lendres/Li-Ion-Boost-Charge-Protect-Boards/Li-ion 5.5A Boost 1A Charge Protect/Li-ion 5.5A Boost 1A Charge Protect.kicad_pcb

## KiCad design Li-ion 5.5A Boost 1A Charge Protect/Li-ion 5.5A Boost 1A Charge Protect.kicad_pcb (2021-11-19)

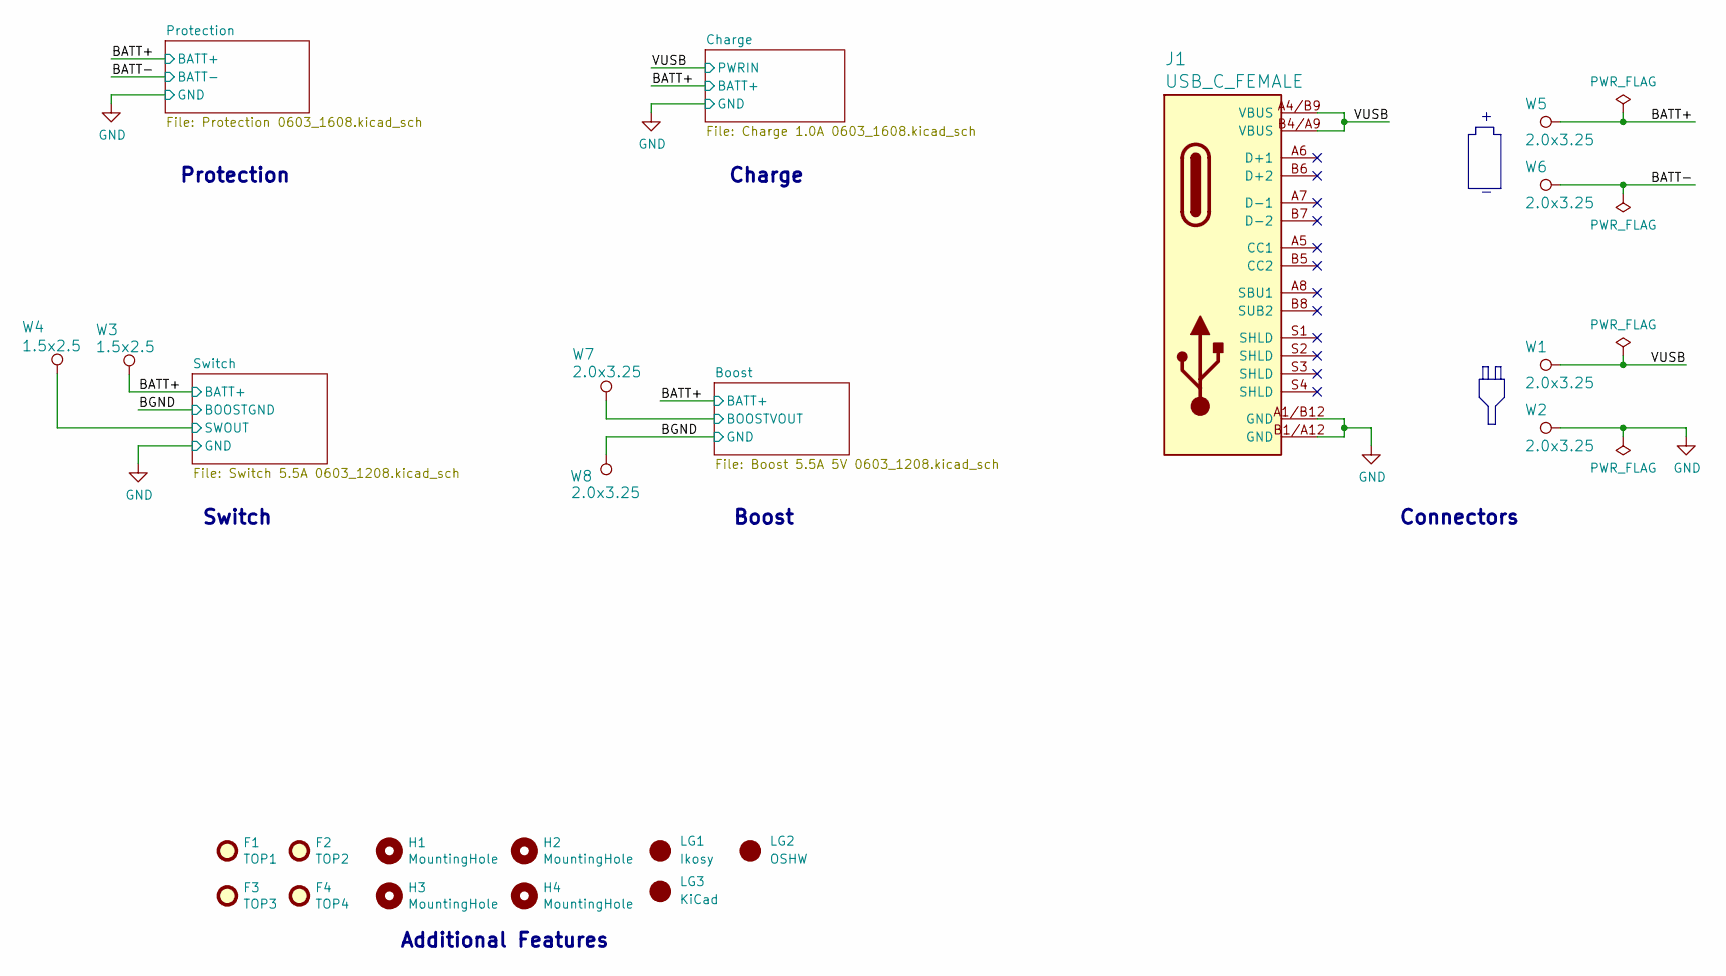
[picture p1: schematic Li-ion 5.5A Boost 1A Charge Protect.kicad_sch, Li-ion 5A Boost 1A Charge Protect]

Parts:
F1, F2, F3, F4: Fiducial; Fiducial_1mm_Mask2mm; Manufacturer Part No. None
H1, H2, H3, H4: MountingHole; MountingHole_2.2mm_M2; Manufacturer Part No. None
J1: USB_C_FEMALE; GCT_USB4110-GF-A; Manufacturer Part No. USB4110-GF-A
LG1: Logo; Ikosy-Logo_Type1_10.3x2mm_SilkScreen; Manufacturer Part No. None
LG2: Logo; OSHW-Symbol_3mm_Silkscreen; Manufacturer Part No. None
LG3: Logo; KiCad-Logo3_3mm_SilkScreen; Manufacturer Part No. None
W1, W2, W5, W6, W7, W8: 2.0x3.25; Pad_2.0-3.25_w_TH; Manufacturer Part No. None
W3, W4: 1.5x2.5; Pad_1.5-2.5_w_TH; Manufacturer Part No. None

Connections:
/BATT+: W3.1, W5.1; also elsewhere on the board
/BATT-: W6.1; also elsewhere on the board
/BGND: W8.1; also elsewhere on the board
/Boost/BOOSTVOUT: W7.1; also elsewhere on the board
/Switch/SWOUT: W4.1; also elsewhere on the board
/VUSB: J1.A4/B9 (VBUS), J1.B4/A9 (VBUS), W1.1; also elsewhere on the board
GND: J1.A1/B12 (GND), J1.B1/A12 (GND), W2.1; also elsewhere on the board

Notes on the sheet:
Protection
Switch
Connectors
Additional Features
Charge
Boost

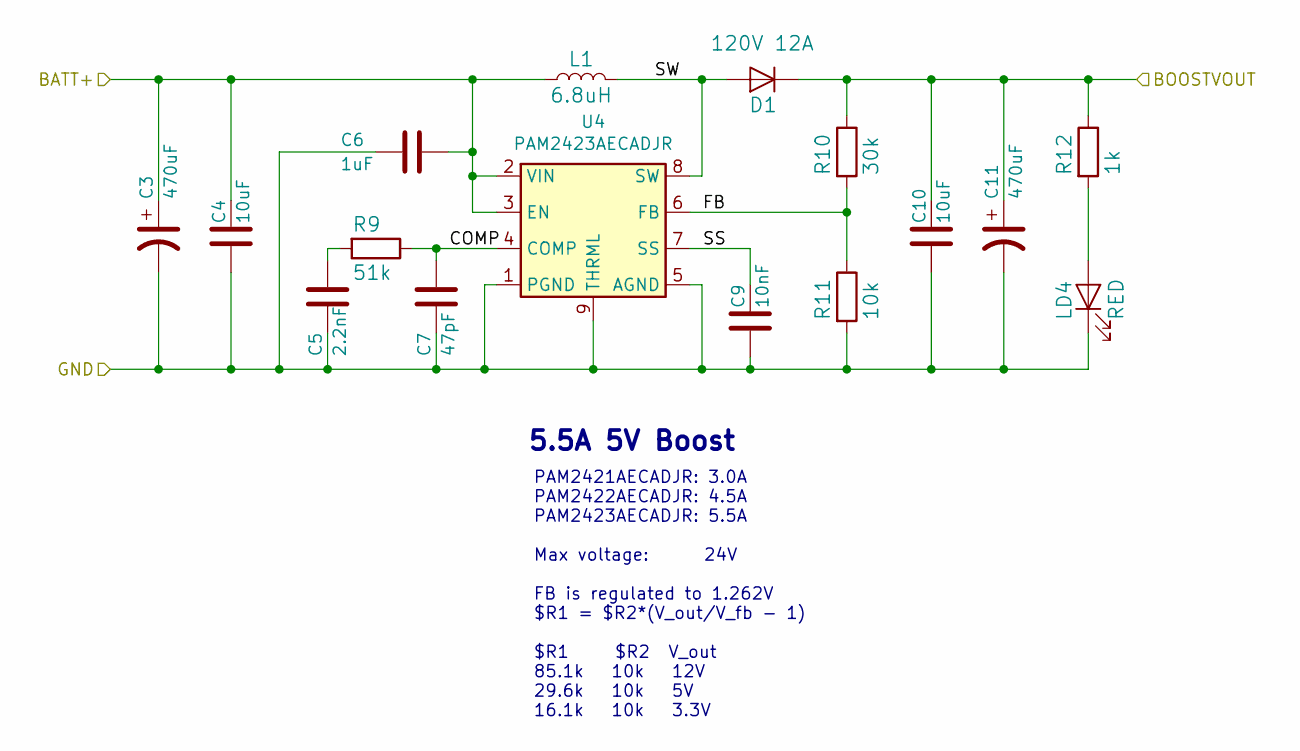
[picture p2: schematic Boost 5.5A 5V 0603_1208.kicad_sch, 5.5A 5V Boost]

Parts:
C3, C11: 470uF; CP_Elec_10x10.5; Manufacturer Part No. 25TLV470M10X10.5
C4, C10: 10uF; 0603_1608Metric; Manufacturer Part No. CL10A106KP8NQSC
C5: 2.2nF; 0603_1608Metric; Manufacturer Part No. CL10B222KB8NFNC
C6: 1uF; 0603_1608Metric; Manufacturer Part No. CL10A105KA8NFNC
C7: 47pF; 0603_1608Metric; Manufacturer Part No. CL10C470JB81PNC
C9: 10nF; 0603_1608Metric; Manufacturer Part No. CL10B103KB8NNNL
D1: 120V 12A; NTS12120EMFST1G; Manufacturer Part No. NTS12120EMFST1G
L1: 6.8uH; L_MGV1004; Manufacturer Part No. MGV10046R8M-10
LD4: RED; LED_0805_2012Metric; Manufacturer Part No. 150080RS75000
R9: 51k; 0603_1608Metric; Manufacturer Part No. ESR03EZPF5102
R10: 30k; 0603_1608Metric; Manufacturer Part No. ESR03EZPF3002
R11: 10k; 0603_1608Metric; Manufacturer Part No. ESR03EZPF1002
R12: 1k; 0603_1608Metric; Manufacturer Part No. ESR03EZPF1001
U4: PAM2423AECADJR; Manufacturer Part No. PAM2423AECADJR

Connections:
/BATT+: C3.1, C4.1, C6.1, L1.1, U4.2 (VIN), U4.3 (EN); also elsewhere on the board
/BGND: C3.2, C4.2, C5.2, C6.2, C7.2, C9.2, C10.2, C11.2, LD4.1 (K(N)), R11.2, U4.1 (PGND), U4.5 (AGND), U4.9 (THRML); also elsewhere on the board
/Boost/BOOSTVOUT: C10.1, C11.1, D1.5 (K), D1.5A (K), D1.5B (K), D1.5C (K), D1.5D (K), R10.1, R12.1; also elsewhere on the board
/Boost/COMP: C7.1, R9.1, U4.4 (COMP)
/Boost/FB: R10.2, R11.1, U4.6 (FB)
/Boost/SS: C9.1, U4.7 (SS)
/Boost/SW: D1.1 (A), D1.2 (A), D1.3 (A), L1.2, U4.8 (SW)
unnamed: C5.1, R9.2
unnamed: LD4.2 (A(P)), R12.2

Notes on the sheet:
5.5A 5V Boost
PAM2421AECADJR: 3.0A PAM2422AECADJR: 4.5A PAM2423AECADJR: 5.5A Max voltage: 24V FB is regulated to 1.262V $R1 = $R2*(V_out/V_fb - 1) $R1 $R2 V_out 85.1k 10k 12V 29.6k 10k 5V 16.1k 10k 3.3V

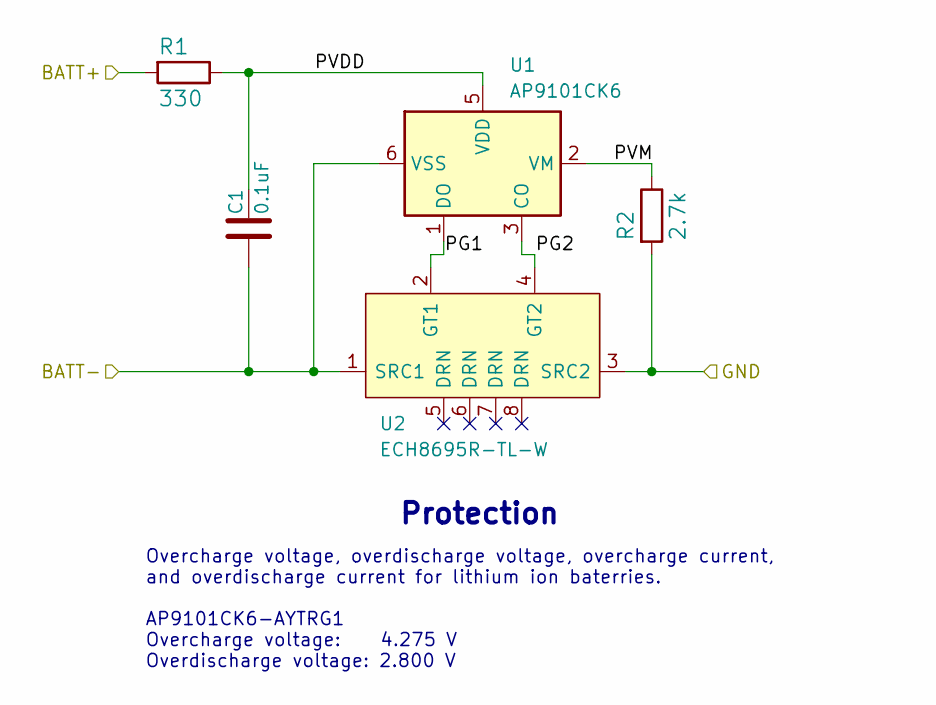
[picture p3: schematic Protection 0603_1608.kicad_sch]

Parts:
C1: 0.1uF; 0603_1608Metric; Manufacturer Part No. CL10B104JB8NNNC
R1: 330; 0603_1608Metric; Manufacturer Part No. BUK6D30-40EX
R2: 2.7k; 0603_1608Metric; Manufacturer Part No. ESR03EZPF2701
U1: AP9101CK6; SOT-23-6; Manufacturer Part No. AP9101CK6-AYTRG1
U2: ECH8695R-TL-W; SOT65P280X95-8N; Manufacturer Part No. ECH8695R-TL-W

Connections:
/BATT+: R1.2; also elsewhere on the board
/BATT-: C1.2, U1.6 (VSS), U2.1 (SRC1); also elsewhere on the board
/Protection/PG1: U1.1 (DO), U2.2 (GT1)
/Protection/PG2: U1.3 (CO), U2.4 (GT2)
/Protection/PVDD: C1.1, R1.1, U1.5 (VDD)
/Protection/PVM: R2.1, U1.2 (VM)
GND: R2.2, U2.3 (SRC2); also elsewhere on the board

Notes on the sheet:
Protection
Overcharge voltage, overdischarge voltage, overcharge current, and overdischarge current for lithium ion baterries. AP9101CK6-AYTRG1 Overcharge voltage: 4.275 V Overdischarge voltage: 2.800 V

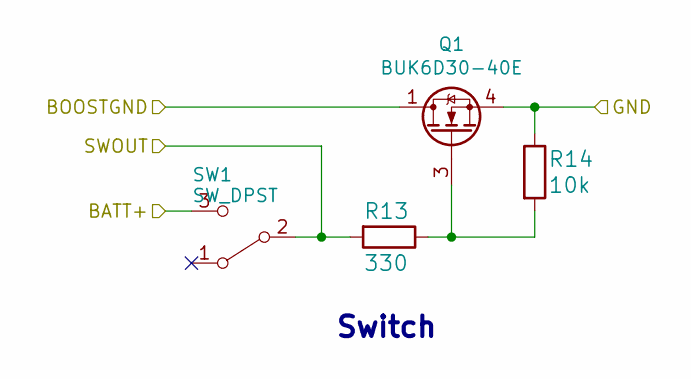
[picture p4: schematic Switch 5.5A 0603_1208.kicad_sch]

Parts:
Q1: BUK6D30-40E; BUK6D3040EX; Manufacturer Part No. BUK6D30-40EX
R13: 330; 0603_1608Metric; Manufacturer Part No. BUK6D30-40EX
R14: 10k; 0603_1608Metric; Manufacturer Part No. ESR03EZPF1002
SW1: SW_DPST; CL-SB-22A_Edge; Manufacturer Part No. CL-SB-22A-11T

Connections:
/BATT+: SW1.3 (2), SW1.6 (2); also elsewhere on the board
/BGND: Q1.1 (D), Q1.2 (D), Q1.5 (D), Q1.6 (D), Q1.7 (D); also elsewhere on the board
/Switch/SWOUT: R13.2, SW1.2 (C), SW1.5 (C); also elsewhere on the board
GND: Q1.4 (S), Q1.8 (S), R14.1; also elsewhere on the board
unnamed: Q1.3 (G), R13.1, R14.2
unnamed: SW1.1, SW1.4 (1)

Notes on the sheet:
Switch

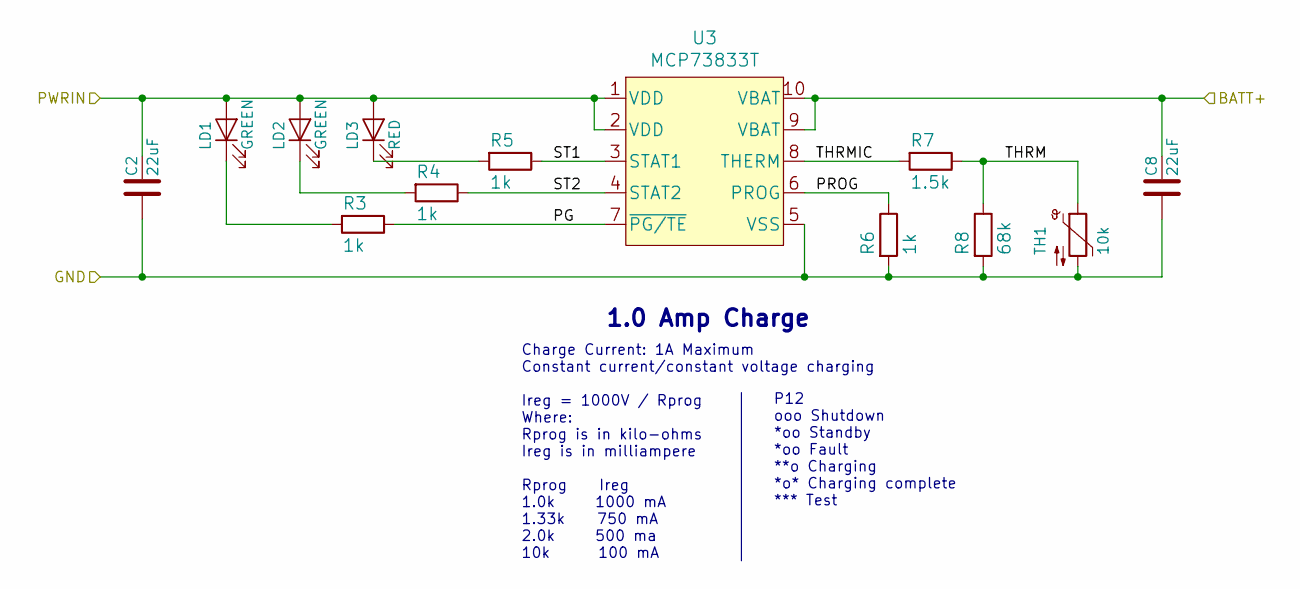
[picture p5: schematic Charge 1.0A 0603_1608.kicad_sch]

Parts:
C2, C8: 22uF; 0603_1608Metric; Manufacturer Part No. CL10A226MQ8NRNE
LD1, LD2: GREEN; LED_0805_2012Metric; Manufacturer Part No. 150080VS75000
LD3: RED; LED_0805_2012Metric; Manufacturer Part No. 150080RS75000
R3, R4, R5, R6: 1k; 0603_1608Metric; Manufacturer Part No. ESR03EZPF1001
R7: 1.5k; 0603_1608Metric; Manufacturer Part No. ESR03EZPF1501
R8: 68k; 0603_1608Metric; Manufacturer Part No. ESR03EZPF6802
TH1: 10k; 0603_1608Metric; Manufacturer Part No. NTCG163JH103JT
U3: MCP73833T; MCP73833; Manufacturer Part No. MCP73833T-AMI/UN

Connections:
/BATT+: C8.1, U3.9 (VBAT), U3.10 (VBAT); also elsewhere on the board
/Charge/PG: R3.1, U3.7 (~PG/TE)
/Charge/PROG: R6.1, U3.6 (PROG)
/Charge/ST1: R5.1, U3.3 (STAT1)
/Charge/ST2: R4.1, U3.4 (STAT2)
/Charge/THRM: R7.1, R8.1, TH1.1
/Charge/THRMIC: R7.2, U3.8 (THERM)
/VUSB: C2.1, LD1.2 (A(P)), LD2.2 (A(P)), LD3.2 (A(P)), U3.1 (VDD), U3.2 (VDD); also elsewhere on the board
GND: C2.2, C8.2, R6.2, R8.2, TH1.2, U3.5 (VSS); also elsewhere on the board
unnamed: LD1.1 (K(N)), R3.2
unnamed: LD2.1 (K(N)), R4.2
unnamed: LD3.1 (K(N)), R5.2

Notes on the sheet:
P12 ooo Shutdown *oo Standby *oo Fault **o Charging *o* Charging complete *** Test
1.0 Amp Charge
Charge Current: 1A Maximum Constant current/constant voltage charging Ireg = 1000V / Rprog Where: Rprog is in kilo-ohms Ireg is in milliampere Rprog Ireg 1.0k 1000 mA 1.33k 750 mA 2.0k 500 ma 10k 100 mA

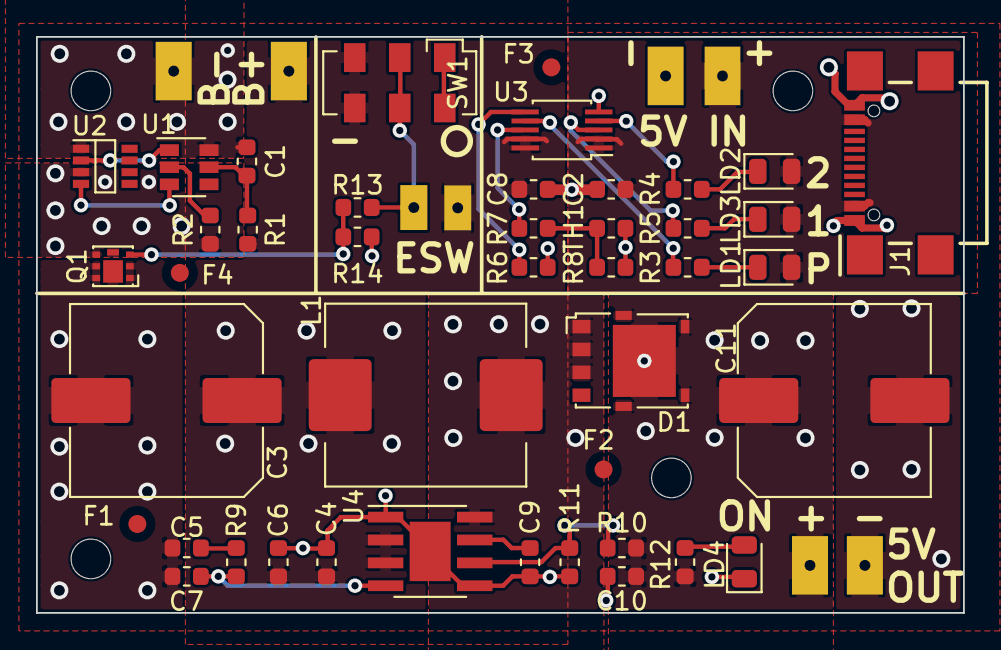
[picture p6: board Li-ion 5.5A Boost 1A Charge Protect.kicad_pcb from above]

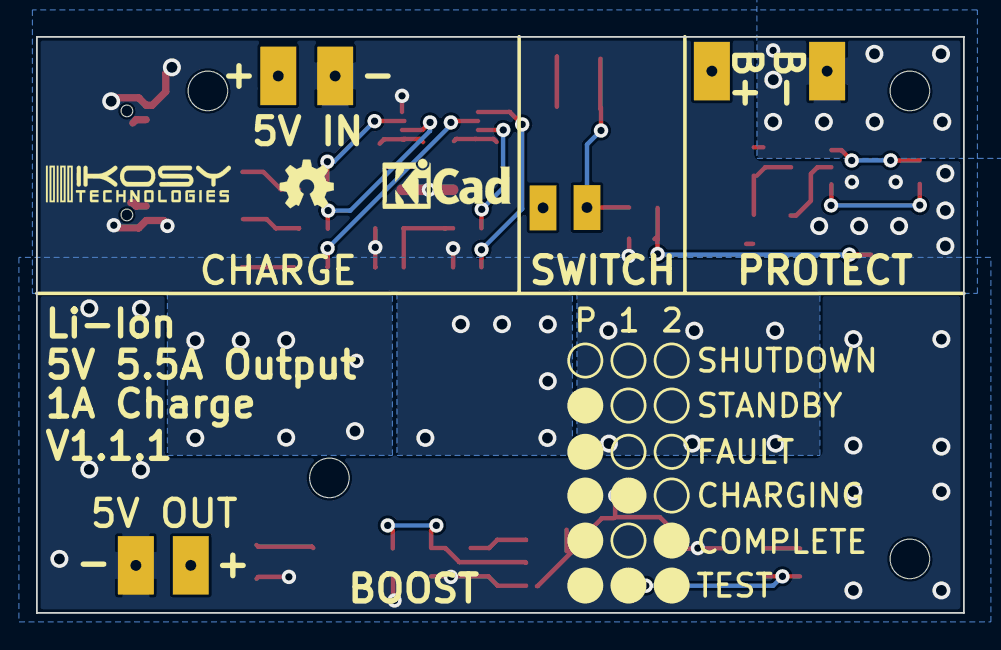
[picture p7: board Li-ion 5.5A Boost 1A Charge Protect.kicad_pcb from below]

Board: 2 copper layers, 51.5 x 32.0 mm, 58 parts (3 on the bottom side), 28 nets.
