lendres/Li-Ion-Boost-Charge-Protect-Boards/(commit log)

2020-08-20 Standarizing libraries
    [Li-ion 5A Boost 1A Charge Protect.kicad_pcb, Li-ion 5A Boost 1A Charge Protect.sch]
2020-08-26 Update Li-ion 5A Boost 1A Charge Protect-cache.lib
2020-10-01 Library updates
    [Bill of Materials.xlsx, Li-ion 5A Boost 1A Charge Protect.kicad_pcb, Li-ion 5A Boost 1A Charge Protect.sch, Li-ion 5A Boost 1A Charge Protect.xlsx]
2021-04-21 Updates after first build, intermediate check in
    [Bill of Materials.xlsx, Li-ion 5A Boost 1A Charge Protect.kicad_pcb, Li-ion 5A Boost 1A Charge Protect.sch]
2021-04-24 Version 1.1 updates
    [Li-ion 5A Boost 1A Charge Protect.kicad_pcb, Li-ion 5A Boost 1A Charge Protect.sch]
2021-04-25 Version 1.1 updates
    Version 1.1 updates
    [Li-ion 5A Boost 1A Charge Protect.kicad_pcb, Li-ion 5A Boost 1A Charge Protect.sch]
2021-04-25 Before moving protection IC
    [Li-ion 5A Boost 1A Charge Protect.kicad_pcb]
2021-04-25 Before reversing mosfet and protection IC
    [Li-ion 5A Boost 1A Charge Protect.kicad_pcb]
2021-04-26 Near complete version 1.1.0
    [Bill of Materials.xlsx, Li-ion 5A Boost 1A Charge Protect.kicad_pcb, Li-ion 5A Boost 1A Charge Protect.sch]
2021-04-29 Renaming 5A to 5.5A
    [Li-ion 5.5A Boost 1A Charge Protect.kicad_pcb, Li-ion 5.5A Boost 1A Charge Protect.sch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]
2021-04-30 Update Li-ion 5.5A Boost 1A Charge Protect.kicad_pcb
    [Li-ion 5.5A Boost 1A Charge Protect.kicad_pcb]
2021-04-30 As submitted for manufacturing
    [Li-ion 5.5A Boost 1A Charge Protect.kicad_pcb]
2021-05-04 Component extraction
    [Boost 5.5A 5V 0603_1208.sch, Charge 1.0A 0603_1608.sch, Li-ion 5.5A Boost 1A Charge Protect.kicad_pcb, Li-ion 5.5A Boost 1A Charge Protect.sch, Protection 0603_1608.sch, Switch 5.5A 0603_1208.sch]
2021-05-04 Update Li-ion 5.5A Boost 1A Charge Protect.sch
    [Li-ion 5.5A Boost 1A Charge Protect.sch]
2021-06-24 House keeping updates.
    [Li-ion 5.5A Boost 1A Charge Protect.kicad_pcb, Li-ion 5.5A Boost 1A Charge Protect.sch]
2021-07-07 Fixed origin for exported file formats.
    [Li-ion 5.5A Boost 1A Charge Protect.kicad_pcb]
2021-07-23 Fixed position on diode.
    Fixed position on diode.
    [Li-ion 5.5A Boost 1A Charge Protect.kicad_pcb]
2021-07-28 Updates for footprint corrections.
    [Li-ion 5.5A Boost 1A Charge Protect.kicad_pcb]
2021-07-28 Rearrange schematic fields, fix 3D view
    [Boost 5.5A 5V 0603_1208.sch, Charge 1.0A 0603_1608.sch, Li-ion 5.5A Boost 1A Charge Protect.sch, Protection 0603_1608.sch, Switch 5.5A 0603_1208.sch]
2021-07-28 Update version text
    [Li-ion 5.5A Boost 1A Charge Protect.kicad_pcb]
2021-09-05 Update Charge 1.0A 0603_1608.sch
    [Charge 1.0A 0603_1608.sch]
2021-09-17 Fix 3D model on inductor
    [Li-ion 5.5A Boost 1A Charge Protect.kicad_pcb]
2021-11-19 Conversion to KiCad version 6.0
    [Boost 5.5A 5V 0603_1208.kicad_sch, Boost 5.5A 5V 0603_1208.sch, Charge 1.0A 0603_1608.kicad_sch, Charge 1.0A 0603_1608.sch, Li-ion 5.5A Boost 1A Charge Protect.kicad_pcb, Li-ion 5.5A Boost 1A Charge Protect.kicad_sch, Li-ion 5.5A Boost 1A Charge Protect.sch, Protection 0603_1608.kicad_sch]
